catphish/accesscontrol/pcb/accesscontrol.kicad_pcb

## KiCad design pcb/accesscontrol.kicad_pcb (2020-06-21)

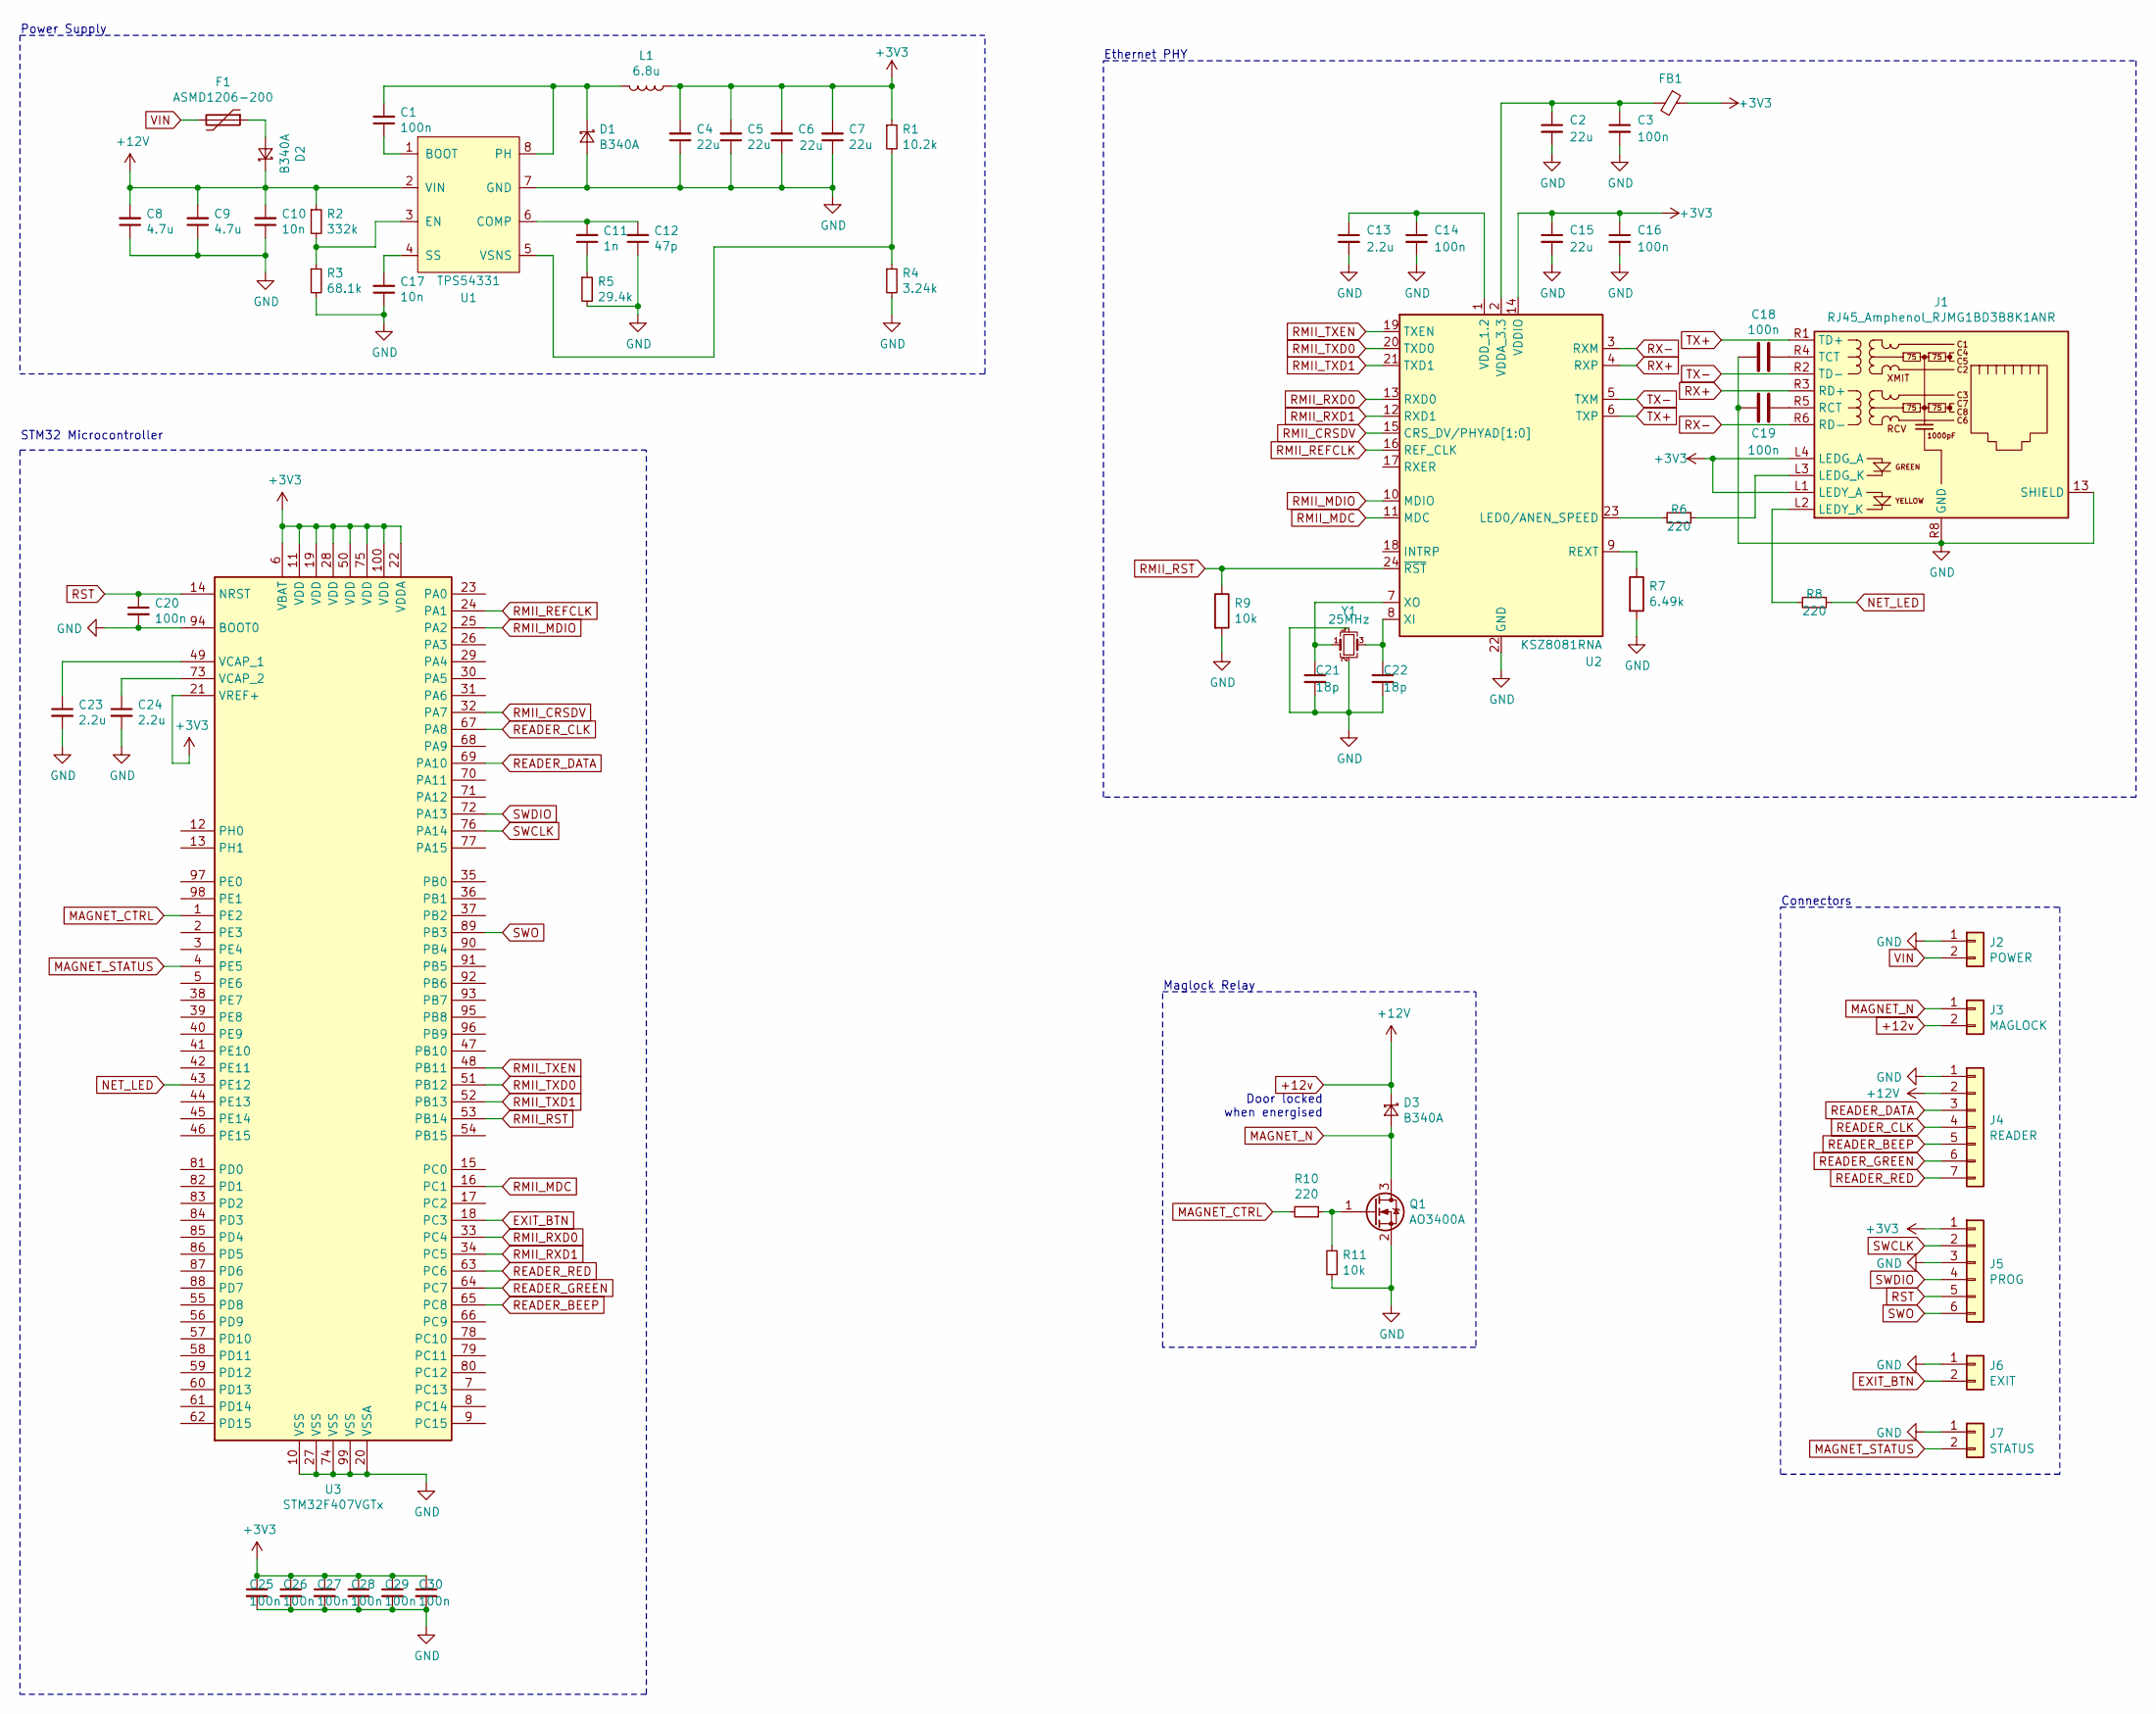
[picture p1: schematic accesscontrol.sch]

Parts:
C1, C3, C14, C16, C18, C19, C20, C25, C26, C27, C28, C29, C30: 100n; C_0603_1608Metric; LCSC C14663
C2, C4, C5, C6, C7, C15: 22u; C_0603_1608Metric; LCSC C59461
C8, C9: 4.7u; C_1206_3216Metric; LCSC C29823
C10, C17: 10n; C_0603_1608Metric; LCSC C57112
C11: 1n; C_0603_1608Metric; LCSC C1588
C12: 47p; C_0603_1608Metric; LCSC C1671
C13, C23, C24: 2.2u; C_0603_1608Metric; LCSC C23630
C21, C22: 18p; C_0603_1608Metric; LCSC C1647
D1, D2, D3: B340A; D_SMA; LCSC C64982
F1: ASMD1206-200; Fuse_1206_3216Metric; LCSC C135342
FB1: Ferrite_Bead_Small; L_0805_2012Metric; LCSC C1017
J1: RJ45_Amphenol_RJMG1BD3B8K1ANR
J2: POWER; TerminalBlock_RND_205-00001_1x02_P5.00mm_Horizontal
J3: MAGLOCK; TerminalBlock_RND_205-00001_1x02_P5.00mm_Horizontal
J4: READER; TerminalBlock_RND_205-00006_1x07_P5.00mm_Horizontal
J5: PROG; PinHeader_1x06_P2.54mm_Vertical
J6: EXIT; TerminalBlock_RND_205-00001_1x02_P5.00mm_Horizontal
J7: STATUS; TerminalBlock_RND_205-00001_1x02_P5.00mm_Horizontal
L1: 6.8u; L_Sunlord_MWSA0518_5.4x5.2mm; LCSC C408348
Q1: AO3400A; SOT-23; LCSC C20917
R1: 10.2k; R_0603_1608Metric; LCSC C22772
R2: 332k; R_0603_1608Metric; LCSC C23139
R3: 68.1k; R_0603_1608Metric; LCSC C25976
R4: 3.24k; R_0603_1608Metric; LCSC C22994
R5: 29.4k; R_0603_1608Metric; LCSC C22974
R6, R8, R10: 220; R_0603_1608Metric; LCSC C22962
R7: 6.49k; R_0603_1608Metric; LCSC C23088
R9, R11: 10k; R_0603_1608Metric; LCSC C25804
U1: TPS54331; SOIC-8_3.9x4.9mm_P1.27mm; LCSC C9865
U2: KSZ8081RNA; QFN-24-1EP_4x4mm_P0.5mm_EP2.6x2.6mm; LCSC C100017
U3: STM32F407VGTx; LQFP-100_14x14mm_P0.5mm; LCSC C12345
Y1: 25MHz; Crystal_SMD_3225-4Pin_3.2x2.5mm; LCSC C9006

Connections:
+3V3: C4.2, C5.2, C6.2, C7.2, C15.1, C16.1, C25.1, C26.1, C27.1, C28.1, C29.1, C30.1, FB1.1, J1.L1 (LEDY_A), J1.L4 (LEDG_A), J5.1, L1.1, R1.1, U2.14 (VDDIO), U3.6 (VBAT), U3.11 (VDD), U3.19 (VDD), U3.21 (VREF+), U3.22 (VDDA), U3.28 (VDD), U3.50 (VDD), U3.75 (VDD), U3.100 (VDD)
+12v: C8.2, C9.2, C10.2, D2.1 (K), D3.1 (K), J3.2, J4.2, R2.1, U1.2 (VIN)
EXIT_BTN: J6.2, U3.18 (PC3)
GND: C2.2, C3.2, C4.1, C5.1, C6.1, C7.1, C8.1, C9.1, C10.1, C12.1, C13.2, C14.2, C15.2, C16.2, C17.1, C18.2, C19.2, C20.2, C21.2, C22.2, C23.2, C24.2, C25.2, C26.2, C27.2, C28.2, C29.2, C30.2, D1.2 (A), J1.13 (SHIELD), J1.R8 (GND), J2.1, J4.1, J5.3, J6.1, J7.1, Q1.2 (S), R3.2, R4.2, R5.2, R7.2, R9.2, R11.1, U1.7 (GND), U2.22 (GND), U2.25 (GND), U3.10 (VSS), U3.20 (VSSA), U3.27 (VSS), U3.74 (VSS), U3.94 (BOOT0), U3.99 (VSS), Y1.2, Y1.4
MAGNET_CTRL: R10.2, U3.1 (PE2)
MAGNET_N: D3.2 (A), J3.1, Q1.3 (D)
MAGNET_STATUS: J7.2, U3.4 (PE5)
NET_LED: R8.1, U3.43 (PE12)
unnamed: C1.1, U1.1 (BOOT)
unnamed: C1.2, D1.1 (K), L1.2, U1.8 (PH)
unnamed: C2.1, C3.1, FB1.2, U2.2 (VDDA_3.3)
unnamed: C11.1, R5.1
unnamed: C11.2, C12.2, U1.6 (COMP)
unnamed: C13.1, C14.1, U2.1 (VDD_1.2)
unnamed: C17.2, U1.4 (SS)
unnamed: C18.1, J1.R4 (TCT)
unnamed: C19.1, J1.R5 (RCT)
unnamed: C21.1, U2.7 (XO), Y1.1
unnamed: C22.1, U2.8 (XI), Y1.3
unnamed: C23.1, U3.49 (VCAP_1)
unnamed: C24.1, U3.73 (VCAP_2)
unnamed: D2.2 (A), F1.1
unnamed: J1.L2 (LEDY_K), R8.2
unnamed: J1.L3 (LEDG_K), R6.1
unnamed: Q1.1 (G), R10.1, R11.2
unnamed: R1.2, R4.1, U1.5 (VSNS)
unnamed: R2.2, R3.1, U1.3 (EN)
unnamed: R6.2, U2.23 (LED0/ANEN_SPEED)
unnamed: R7.1, U2.9 (REXT)
READER_BEEP: J4.5, U3.65 (PC8)
READER_CLK: J4.4, U3.67 (PA8)
READER_DATA: J4.3, U3.69 (PA10)
READER_GREEN: J4.6, U3.64 (PC7)
READER_RED: J4.7, U3.63 (PC6)
RMII_CRSDV: U2.15 (CRS_DV/PHYAD[1:0]), U3.32 (PA7)
RMII_MDC: U2.11 (MDC), U3.16 (PC1)
RMII_MDIO: U2.10 (MDIO), U3.25 (PA2)
RMII_REFCLK: U2.16 (REF_CLK), U3.24 (PA1)
RMII_RST: R9.1, U2.24 (~RST), U3.53 (PB14)
RMII_RXD0: U2.13 (RXD0), U3.33 (PC4)
RMII_RXD1: U2.12 (RXD1), U3.34 (PC5)
RMII_TXD0: U2.20 (TXD0), U3.51 (PB12)
RMII_TXD1: U2.21 (TXD1), U3.52 (PB13)
RMII_TXEN: U2.19 (TXEN), U3.48 (PB11)
RST: C20.1, J5.5, U3.14 (NRST)
RX+: J1.R3 (RD+), U2.4 (RXP)
RX-: J1.R6 (RD-), U2.3 (RXM)
SWCLK: J5.2, U3.76 (PA14)
SWDIO: J5.4, U3.72 (PA13)
SWO: J5.6, U3.89 (PB3)
TX+: J1.R1 (TD+), U2.6 (TXP)
TX-: J1.R2 (TD-), U2.5 (TXM)
VIN: F1.2, J2.2

Notes on the sheet:
Power Supply
STM32 Microcontroller
Ethernet PHY
Connectors
Maglock Relay
Door locked when energised

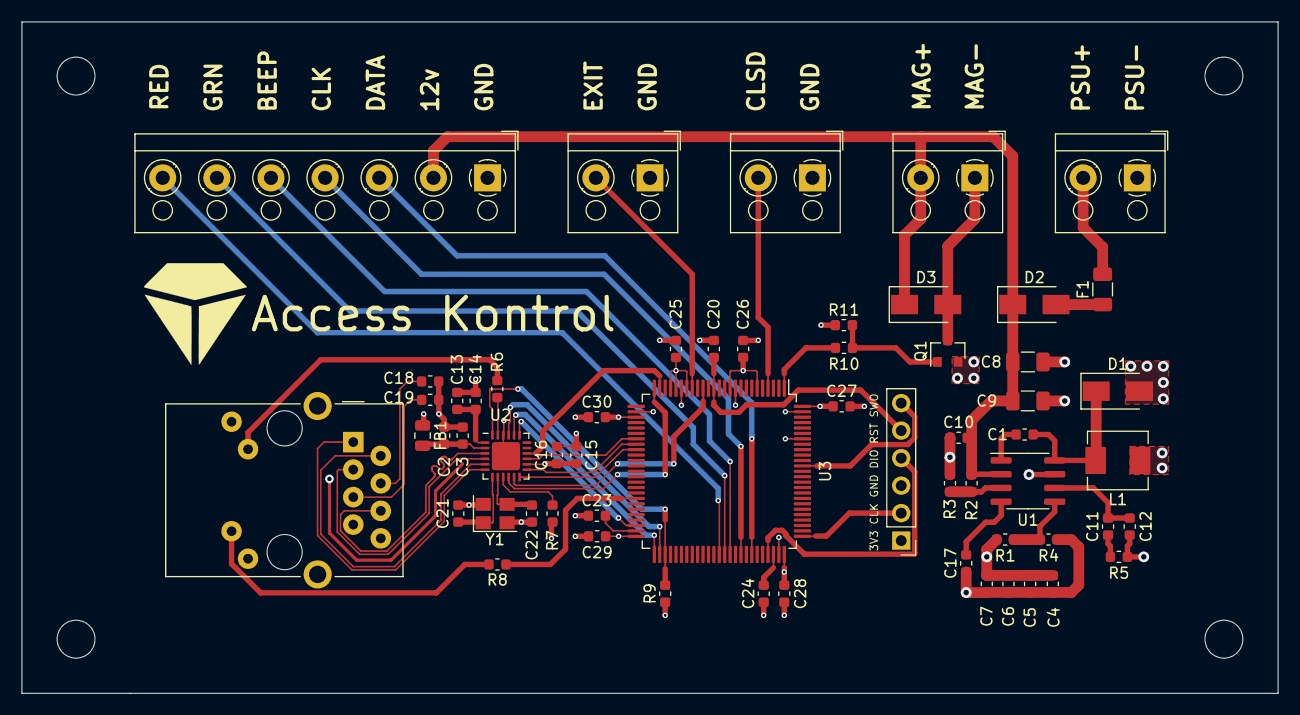
[picture p2: board accesscontrol.kicad_pcb from above]

Board: 4 copper layers, 116.0 x 62.0 mm, 59 parts (0 on the bottom side), 53 nets.
