catphish/accesscontrol/gpio.c

#include <stdint.h>
#include "board.h"

void gpio_init() {
  RCC->AHB1ENR |= RCC_AHB1ENR_GPIOAEN;
  RCC->AHB1ENR |= RCC_AHB1ENR_GPIOBEN;
  RCC->AHB1ENR |= RCC_AHB1ENR_GPIOCEN;
  RCC->AHB1ENR |= RCC_AHB1ENR_GPIOEEN;;
  RCC->AHB1ENR |= RCC_AHB1ENR_GPIOGEN;
  GPIOA->OSPEEDR = 0xFFFFFFFF;
  GPIOB->OSPEEDR = 0xFFFFFFFF;
  GPIOC->OSPEEDR = 0xFFFFFFFF;
  GPIOE->OSPEEDR = 0xFFFFFFFF;
  GPIOG->OSPEEDR = 0xFFFFFFFF;
}

void gpio_port_mode(GPIO_TypeDef * port, uint32_t pin, uint32_t mode, uint32_t af, uint32_t pupdr, uint32_t otyper) {
  port->MODER &= ~( 3 << (pin * 2));
  port->MODER |= (mode << (pin * 2));
  if(pin > 8) {
    port->AFR[1] &= ~(0xF << ((pin-8) * 4));
    port->AFR[1] |= af << ((pin-8) * 4);
  } else {
    port->AFR[0] &= ~(0xF << (pin * 4));
    port->AFR[0] |= af << (pin * 4);
  }
  if(otyper) {
    port->OTYPER |= (1<<pin);
  } else {
    port->OTYPER &= ~(1<<pin);
  }
  port->PUPDR &= ~(3 << (pin * 2));
  port->PUPDR |= pupdr << (pin * 2);
}
