catphish/accesscontrol/(commit log)

2020-05-24 reader LEDs
2020-06-21 add exit button, remove support for dev board
2020-06-21 add hardware
    [accesscontrol-B_Cu.gbr, accesscontrol-B_Mask.gbr, accesscontrol-B_SilkS.gbr, accesscontrol-Edge_Cuts.gbr, accesscontrol-F_Cu.gbr, accesscontrol-F_Mask.gbr, accesscontrol-F_SilkS.gbr, accesscontrol-In1_Cu.gbr]
